danadeutsch/BedOccupancyAlarmClock/FinalProjectReports/Proposal/423Proposal.pdf

## MECH 423 Final Project Proposal The No Excuses Waking Up System

Dana Deutsch - 10631166
deutschdana@gmail.com

November 1st 2020

## Contents

1 Objectives | 3
2 Rationale | 3
3 Functions | 4
4 Bed Occupancy Detection Circuitry and Calibration | 5
5 Main MCU Timing Code for Alarms | 11
6 Phone audio detection and audio output | 12
7 Most Critical Module | 13
8 Risk and Countermeasures | 15
9 Learning Objectives | 15

## 1 Objectives

The goal of this project is to create an alarm clock system for people who have a hard time waking up and getting out of bed. Many people simply turn off their alarms and fall back asleep. Then they must to set multiple alarms at various intervals to remind themselves to get up. This is a temporary solution since you can still turn off all the alarm and stay in bed. My objective of my system is to eliminate the possibility of remaining in bed by taking away the power to fully ”turn off” the alarm while keeping a short ”snooze” functionality. The reason for the snooze is because people enjoy laying in bed for a few minutes before fully waking up and a consistent alarm while in bed will get annoying. Since most people don’t use a physical alarm clock and instead use their phones, this system will work best if it were to interface with the phone people already use.

Creating a phone application interface is outside the scope of this project as it adds a lot much functions and complexity for the short timeline provided. Instead the goal of the project is to use the phone alarm sound as a trigger point for an bed detecting alarm system which operates separate from the phone, This way the main alarm can be set on the phone which users already have set up since it has a better interface and more alarm features. However , the device run on the a microcontroller still operates in respect to the phone. The device will sense when the phone alarm goes off in order to begin its functions instead of having its own internal real time clock and alarm setting capacity. After the original alarm, the device will periodically ring after the user ”snoozes” until the user leaves the bed and doesn’t return to bed for a set amount of time. The device will look like a small box that is placed by the bed right where the user normally places their phone to charge. The device will have small wires leading to sensors under the bed to connect to the detection circuitry.

## 2 Rationale

I want to make this device since it solves a problem I face daily along with many other people. Instead of setting up 5 different alarms which are close together and spread out to make sure I get up, I can use this device. I sometimes ignore my alarms and just decide to keep sleeping so this way I will be forced to get up and hopefully fix my sleeping scheduled. This product isn’t available on the market right so its only achievable by making it myself. I hope this project will provide a concept functionality prototype for a possible market device that uses this method or a better phone app interface. As well many home automation can be made using the bed occupancy detection function like starting the coffee maker when you leave the bed. An example of how I imagine a final product to look like is found in Figure 1.


Figure 1: Concept Drawing For a Alternative Version of the Device Integrated in a Phone Charging Station

## 3 Functions

The functional requirements are found in Table 1. The hardware components include the microcontroller (MCU), a input force sensor for the bed, input audio sensor circuitry for detecting the phone alarm, and output buzzer to create its own alarm sounds. The MCU is used to to control the logic for when the alarm are rung and when to detect and control the inputs and outputs. The MCU code must read the output of the force and sound sensor to detect if the user is in bed or if the phone has rung based on calibration values. The MCU also sends an output signal to play a buzzer for the alarm sounds.

I created a few requirements for the functions ordered by importance. The MCU alarm ringing code cannot be tricked to stop its detection logic. The bed sensor must be able to consistently detect the user regardless of their position in bed. The detection of the user must also be integrated without compromis-ing the bed comfort or permanently changing the bed structure. The buzzer must be laud enough to wake a person from a light sleep. Since deep sleep wont be achievable in the ”snooze time”, the phone alarm will be the main sound that will wake the user. Lastly the sound detection shouldn’t get accidentally triggered by a person talking while on the bed.

Table 1: Functional Requirements for The Wake Up System
| Functions | % Effort
1 2 3 | Bed Occupancy Detection (Circuitry and Calibration Code) MCU Alarm Control Code Phone Audio Detection and Output (Circuit and Code) | 50 30 20

## 4 Bed Occupancy Detection Circuitry and Calibration

Approach and Design

For the bed detection circuitry I research possible solution and found two solutions for sensors that should work by looking at online projects. The first used half-bridge load cells, particularly the types found in bathroom scales. The second method uses thin film force sensitive resistors (FSR) which are created based on a material which changes it’s resistance due to being pinched and flexed. I had also considered off the shelf products which are expensive. The only market product I found which almost meets this function is a bed detection mat for the elderly which are used to see if the user has fell, and alert a special service to come help them. I plan to first try the half bridge strain gauges load cell solution and if it doesn’t work I have the FSR solution as backup. The reason for choosing the load cells instead of the FSR are found in this section and Table 2 summarizes this comparison. Apart from the circuitry the solution will also need to be calibrated to determine values for when the code considers the bed occupied or not.

A bathroom scale has four force sensors at the corners which are actually strain gauged sheet metal parts. Each sensor is a half bridge with each side having opposites effects from compression and tension. I plan to purchase a set from amazon from 13$ which also comes with a 24 bit Analog to Digital Converter (ADC) and amplifier , HX711, pictured in figure 2. To measures the weight we position the strain gauges in a Wheatstone bridge circuit. The HX711 then amplifies the signal across the bridge and converts it to a 24 bit digital signal to provide precision. These sensors are commonly used to create scales using an Arduio therefore there is a lot of online documentation and libraries I can read and adapt on configuring them to the MSP430. In figure 3 I show how a Wheatstone bridge interfaces with the ADC module. In figures 4 and 5, I have the block diagram for the HX711 module and Schematic for the board. The interface for the HX711 is a digital output so to read one 24 bit value I will need to input 25 clock signals and capture the outputs with an MCU code, the process is described in the HX711 data sheet and a small capture is seen in figure 6.

Since I don’t need to measure the exact weight of the user for this function, only a change is the overall detected weight, I plan to place the sensors at only one or two corners of the bed which should create sufficient detection without capturing the full forces of the bed. This makes the device easier to use, install, and over all more adjustable for other beds. Another positive aspect of the design is that it doesn’t inter-fere with the mattress or pillow which can make changing the sheets more difficult or reduce user comfort.


Figure 2: The 4 bathroom scale load cells and 24 ADC module

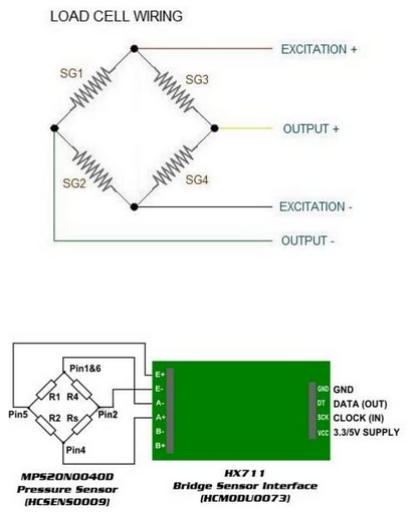
[picture p37: figure]

Figure 3: Measuring Across a Wheatstone Bridge

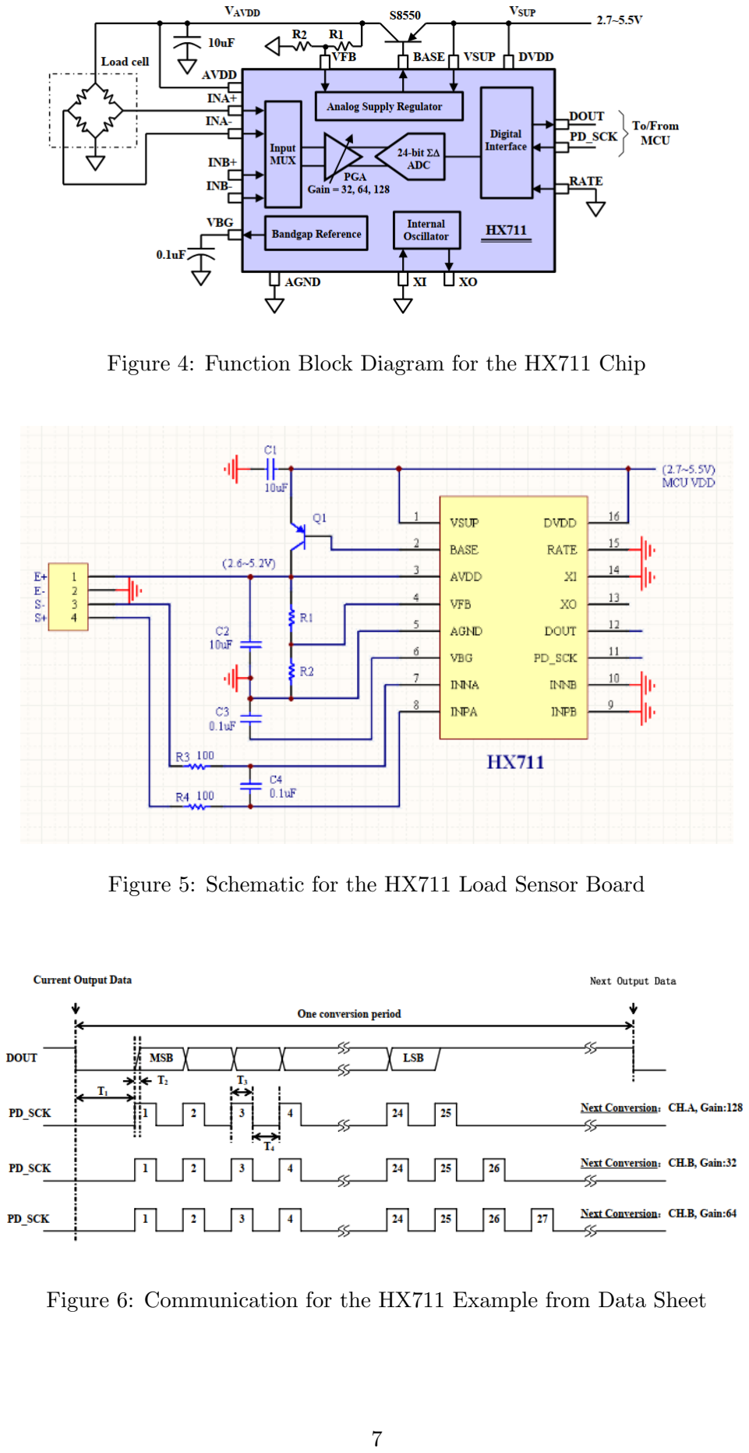
[picture p38: page 7]

Figure 4: Function Block Diagram for the HX711 Chip

Figure 5: Schematic for the HX711 Load Sensor Board

Figure 6: Communication for the HX711 Example from Data Sheet

From concept testing I devised that placing two sensors under the corner of the bed should be sufficient since each sensor supports up to 50kg. The rough measurements I got from my preliminary test was around 32kg appearing at one corner with myself laying on the bed. I want to include a margin for larger beds as mine is light, other weight users, and safety. Figure 7 shows my test of an opened bathroom scale with the two gauges removed and placed under one bed leg. In this picture I show an empty bed at 15kg under a bed leg. The full diagram of the circuit I plan to make is found in figure8.

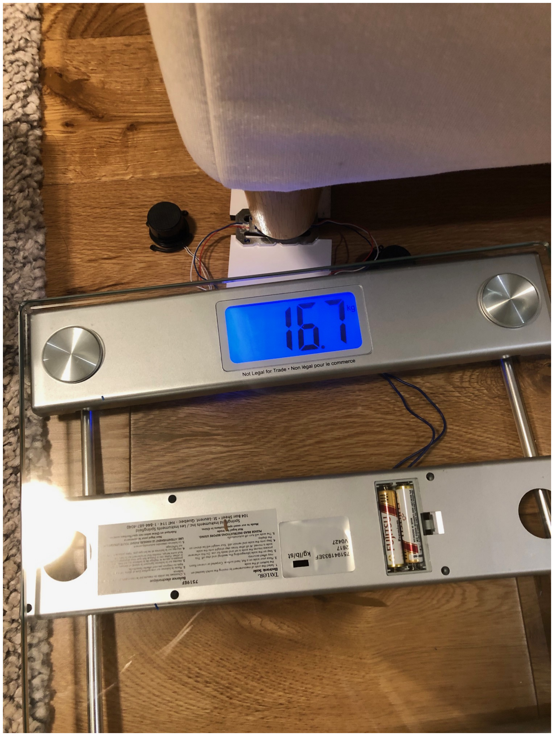
[picture p39: figure]

Figure 7: Preliminary Test With Bathroom Scale


Figure 8: Connection Schematic for The Full Load Cell design

The second solution I am considering as a back up is using force sensitive resistors (FSR). This thin film resistor reduce their resistance when pinched or flexed. I plan to use a long thin resistor which will also detect flex and place it under the mattress on top of the bed slats. Other possible locations to mount this resistors also include right under the user head on the pillow, and right under the user upper body on top of the mattress. The measured value from this is an analog input into the MCU’s ADC. However, this solution might cause interference with the bed sheets and might not have enough pressure to provide results. Also to recognize if the user is on the bed in any position I may need more than one resistor and spread them out on the bed. As well different bed frames and mattresses flex a different amount so there is uncertainly if my bed would work. I have also read that these resistors are fragile and I want the product to be robust and durable with different beds. For these reasons and those in 2, this will be my backup solution. Figure 9 and figure 10 show the FSR and how it can be connect to the MCU in a voltage divider.


Figure 9: Preliminary test with bathroom scale

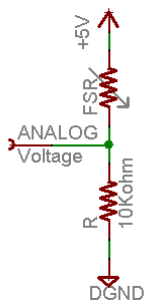
[picture p40: figure]

Figure 10: Preliminary test with bathroom scale

Table 2: Comparing the two top bed detecting occupancy solutions
Solution | Positives | Negatives
Load Cells | Independent to actual bed structure Worked in online sources Cheaper | Each cell max to 50kg More complex electrical setup and integration Need mechanical holders for the gauges
FSR | Simple circuit and code No mechanical setup | At least double the cost Require positioning around the mattress Could snag wiring from sheets

Inputs and Outputs

The main input to this function is the person providing force by laying on the bed. As well, we provide the supply voltage VCC from the MCU for the sensor circuit. The main output is the digital or analog value of the detected voltage. Each concept has different inputs and outputs seen in the table 3. The table lists both the output of the circuit and the output from the reading sensor code needed to read the circuit voltage output.

Table 3: Output for Bed Detection Concepts
Concept | Inputs | Outputs
Load Cells | Pulses for reading ADC value VCC | Circuit: Digital value for the voltage from ADC Code: A state variable post calibration value comparison
FSR | VCC | Circuit: Analog voltage for MCU’s ADC10 Code: A state variable post calibration value comparison

Parameters

I will need to power the sensors at Vcc and detect the output value. The main parameter is the voltage value which is measured across the changing resistances. As well I need need a parameter for calibration of an empty bed and another value as the passing value to signify a person is in bed.

Development Plan

I have two development plans, one for each concept.

Half-Bridge force sensor:

Connect full bridge detection circuitry using only two force sensors

Create MCU code to read the digital outputs

Determine if the change is significant when off and on the bed

Connect 4 force sensors in the bridge at two different corners if needed

Determine calibration values

FSR resistor force sensor:

Connect detection circuitry

Create MCU code to read the ADC values

Determine if the change is significant when off and on the bed by moving around the placement of the resistors to various positions around the bed

Determine calibration values

Test Plan

To test the user detection I will lay at various locations on the bed and read the outputs. If the location and position is indeterminate to the final output from the reading code and all pass as the user is in bed than I will consider it a pass. An optional test which isn’t critical is to place various items like a laptop, laundry basket, and some textbooks on the bed to check the detection isn’t too sensitive. This test doesn’t need to pass since alarm wont be sounding in these cases.

## 5 Main MCU Timing Code for Alarms

Approach and Design

The MCU is the control behind when the alarms go off based on our hardware inputs. The flowchart to the logic behind the alarms are found in figure 5. The code will relay on the use of MCU timers. I will be creating this code under assumptions that the inputs will be digital high or low values simulated using IO pins. This will be changed when combining this function’s MCU code with the code for reading each sensor. Some features of the flowchart include not ringing the alarm originally if the person isn’t in bed but still check they don’t return to bed in case they just happen to get up a few minutes before the alarm. As well if the person returns to bed after exiting, the counter for waiting at least an hour to ensure they don’t return will be reset.

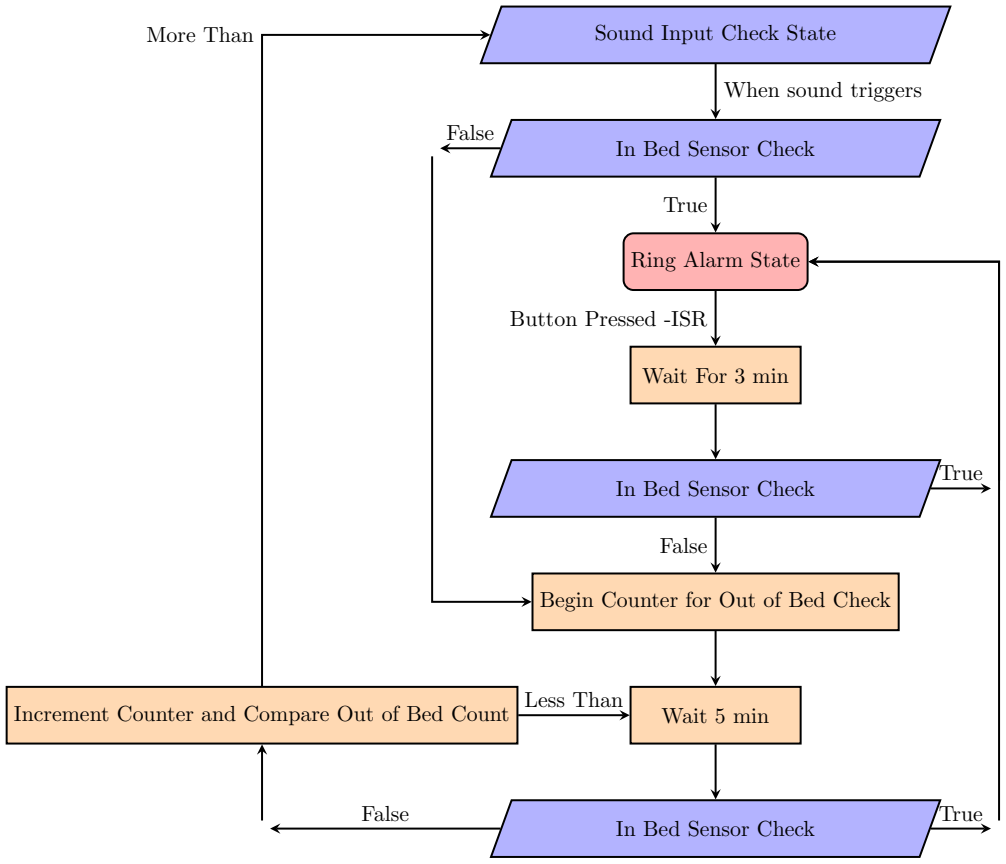
[picture p41: figure]
Sound Input Check State; In Bed Sensor Check; Ring Alarm State; Wait For 3 min; Begin Counter for Out of Bed Check; Wait 5 min; When sound triggers; True; False; Button Pressed -ISR; Less Than; More Than

Increment Counter and Compare Out of Bed Count

Figure 11: Flowchart for the Alarm Actuation Logic

Inputs and Outputs

The main input is the determined output from the bed occupancy detection. This will be a Boolean value to determine if the level passed the allowed amount and the person is in bed. The second input is the output from the phone audio sensor which actuates the entire flow chart. The third input is a snooze button for the user to temporarily turn off the alarm. Finally we have the output buzzer to get the user out of bed which will be set with a PWM signal to change frequencies of sound. I would also want to include some LEDs for user visual feedback to show if the device is sensing a person in bed and that the device is either idle or in the wake up sequence.

Parameters

The software will check and use the following to function:

The state of the bed as a digital high or low

The state of the audio volume as a digital high or low

Count of number of times the secondary alarm has gone off to provide enough time for out of bed detection

Time for waiting between snooze to be converted into frequency of the timer and possibly a count variable is frequency isn’t achievable

Time for waiting between checking if the bed is still empty to be converted into frequency of the timer and possibly a count variable is frequency isn’t achievable

PWM duty cycle for the piezo buzzer

Development Plan

I will develop this function first independently from the other functions and than merge them. Therefore originally the inputs to the system will be simulated before the real inputs are merged.

Develop code for the first half of the flow chart which stops the snoozing loop when user exits bed

Use a buzzer output, snooze push button input, and digital high or low values for the bed and volume detection to test the state machine

Develop the second half of the flow diagram code that checks the our of bed sequence

Test flow again

Swap the digital inputs for the outputs of the other functions when merging

Test Plan

Testing on the code will be preformed using test cases based testing of the state machine. I will basically pretend to be the user using the simulated inputs. I will try combinations of ”leaving” and ”exiting” to test the state machine.

## 6 Phone audio detection and audio output

Approach and Design

This function encompasses the two sound related traducers I plan to use and the code controlling them. To detect the phone alarm, as long as the phone is placed right on top of the product, I can measure the volume of sounds and only actuate on laud enough sounds using a microphone. I found a microphone attached with a audio amplifier board seen in figure 12. The schematic of this board is found in figure 13 which uses the MX4466 Op-Amp. Reading the analog input with the ADC on the MCU I can determine the value for the phone ringing to calibrate the sensor. Other sensors are also available with can be adjusted with an external resistor to provide a digital output once the voltage is overcome. This type can be used to create an IO pin interrupt instead of using the ADC.

Figure 12: The Audio board in Plan

To create the output alarm I plan to use a piezo buzzer which I already have from another project. This is of lesser importance since the sound quality and volume wont be deterministic of the functionality and can be adjusted at a later date. To provide voltage to the buzzer I will provide a PWM signal to control the output.

Inputs and Outputs

The input to the buzzer system is a Boolean value from he main code to trigger the buzzer. As well the input to the microphone is the sound of the phone alarm to the microphone creating the signal for detection. The system output is a PWM signal to power the buzzer to output sounds. The microphone sensor output is a signal that needs to be read by the MCU’s ADC.

Parameters

The main parameter is the value for calibrating if the audio sensor has heard the phone ringing alarm. The second parameter is then the Boolean value to provide to the main MCU code as input. The third value is the duty cycle which controls the buzzer.

Development Plan

The plan is to develop the buzzer first as its simpler while I am focused on bed detection and main code functions. Only later will I test the microphone since it is a lower deterministic function and the device will still mainly function without it. This is mentioned in section 8 where I discuss the risks.

The plan:

Connect buzzer and check it’s sound and adjust pwm input

Connect microphone and create MCU code to read its values

Determine if microphone can distinguish the alarm should from normal background noise

Record calibration value

Test Plan

The test plan for the buzzer is simple, see if the sound is outputted and is heard well enough. For the microphone I want to test various phone alarm tones to check it can detect them and detain how close or far away to the microphone I need to be in order to trigger my code.

## 7 Most Critical Module

The most critical and deterministic function is the bed occupancy detection since without it the whole thing wont work. For this reason I have outlined two solutions for the detection system. I have already


Figure 13: Microphone Board Schematic preformed preliminary tests on the half bridge concept by disassembling a bathroom scale and placing on of its sensors under a leg of my bed, seen in figure 7. The scale displayed two different values when the bed was empty and occupied. This proves that this method would function once it is properly imple-mented though implementation could be tricky. There is no preliminary test I can do for the FSR before purchasing it and testing it as outlines in its development plan.

## 8 Risk and Countermeasures

The biggest risk is not getting the bed detection to work which is the most critical function. Because of its complexity it could be time heavy as well and therefore I will prioritize this function over the rest which could cause the other functions to be incomplete. I have two methods for this function as a countermeasure if one doesn’t work. If I am not able to get the bed detection to work on the bed I will try to show a proof of concept solution. This could be making it into a chair occupancy instead which is a more rigid structure and has a smaller scale than the bed.

Another risk is the sound sensor not being sensitive enough and wont distinguish between an alarm or someone yelling in the room. Finally a big risk is not being able to implement all functions in time. I am open to the possibility if I ran out of time to not complete the audio sensor as it’s a simpler function and the device still work with a button to begin its functionality instead. All it will mean for the user, is that they turn the device on instead of it being related to the phone. I will try to start my main two functions early for this risk. As well due to the at home situation, if something need to be purchased it could take longer to arrive or I will be delayed if I need to get emplacements for sensors. There is no avoiding this risk except purchasing the sensors early to make sure i have time to exchange if they wont work and have enough time for shipping.

## 9 Learning Objectives

By preforming this project I will work on my MCU coding skills by creating a flow of code functions. I will use timer functionality, and ADC functionality as well as general ISR and IOs. I will learn about audio signals from the volume sensor and buzzer. Finally I will gain experience using Wheatstone bridge for strain gauges sensors and learning about their uses.
