danadeutsch/BedOccupancyAlarmClock/FinalProjectReports/presentation/fullcycle.xlsx

Time | Xo [counts] | Vo [counts/s]
8679944
8680052
8679913
8679929
8679883
8680201
8679842
8679853
8679941
8679930
8679928
8679889
8679875
8679910
8679892
8679938
8679905
8679935
8679960
8679914
8680008
8679899
8679946
8679954
8679932
8679915
8679947
8679907
8679899
8679967
8679852
8679918
8679916
8679932
8679937
8679950
8680133
8680003
8680370
8680310
8679803
10069253
9878541
9840378
10004138
9982004
9974542
9981735
9959610
9796029
9803634
9797335
9896620
10094777
9948625
9878324
9847597
9851958
9849582
9859729
9832212
9500629
9623865
9489222
9506327
9522563
9526311
9525368
9548246
9579059
9573851
9584079
9566930
9555485
9536613
9536062
9536033
9537856
9538532
9538221
9539776
9546887
9600159
9740700
9740700
9690989
9684781
9693465
9667196
9650987
9639574
9646911
9396952
9444494
9745314
9688479
9672544
9689875
9685917
9688467
9686674
9817786
9813047
9823850
9691509
9736422
9729311
9725384
9720872
9721176
9722284
9724227
9721374
9717868
9721493
9721548
9722482
9722953
9720951
9823713
9819952
9821782
9623075
9712462
9724785
9725510
9723284
9723837
9729213
9726556
9729632
9727652
9696369
9766243
9762671
9753477
9845710
9828516
9889332
9552332
10118113
8681930
8681029
8681501
8681210
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
