danadeutsch/BedOccupancyAlarmClock/FinalProjectReports/Final/UI.PNG

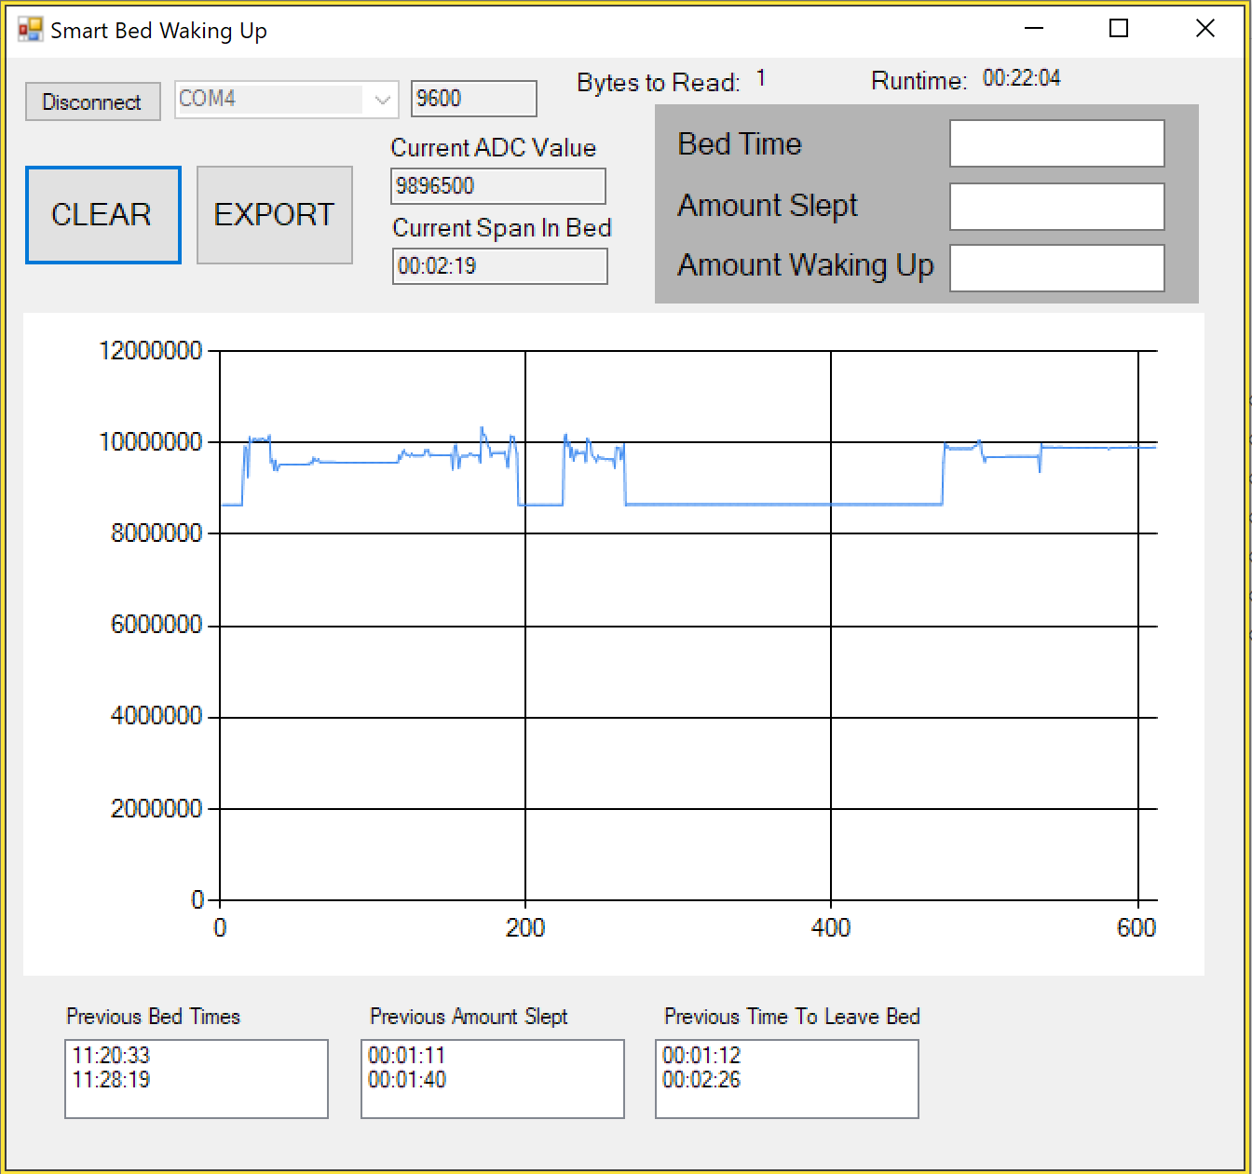
FinalProjectReports/Final/UI.PNG
