danadeutsch/BedOccupancyAlarmClock/FinalProjectReports/Final/underBedLed.PNG

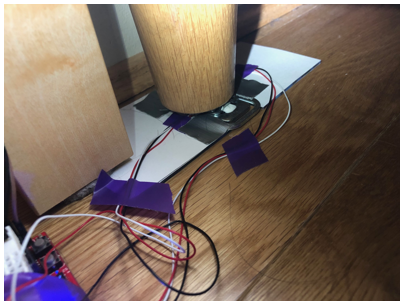
FinalProjectReports/Final/underBedLed.PNG
