danadeutsch/BedOccupancyAlarmClock/FinalProjectReports/Final/underBedLegUnloaded.PNG

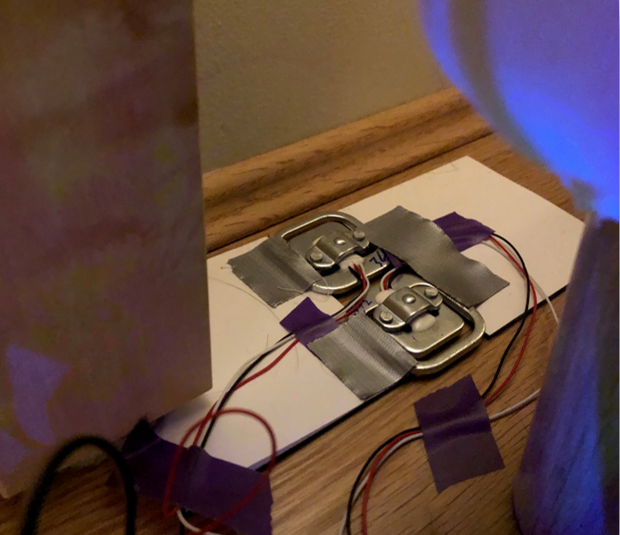
FinalProjectReports/Final/underBedLegUnloaded.PNG
