danadeutsch/BedOccupancyAlarmClock/FinalProjectReports/presentation/display.PNG

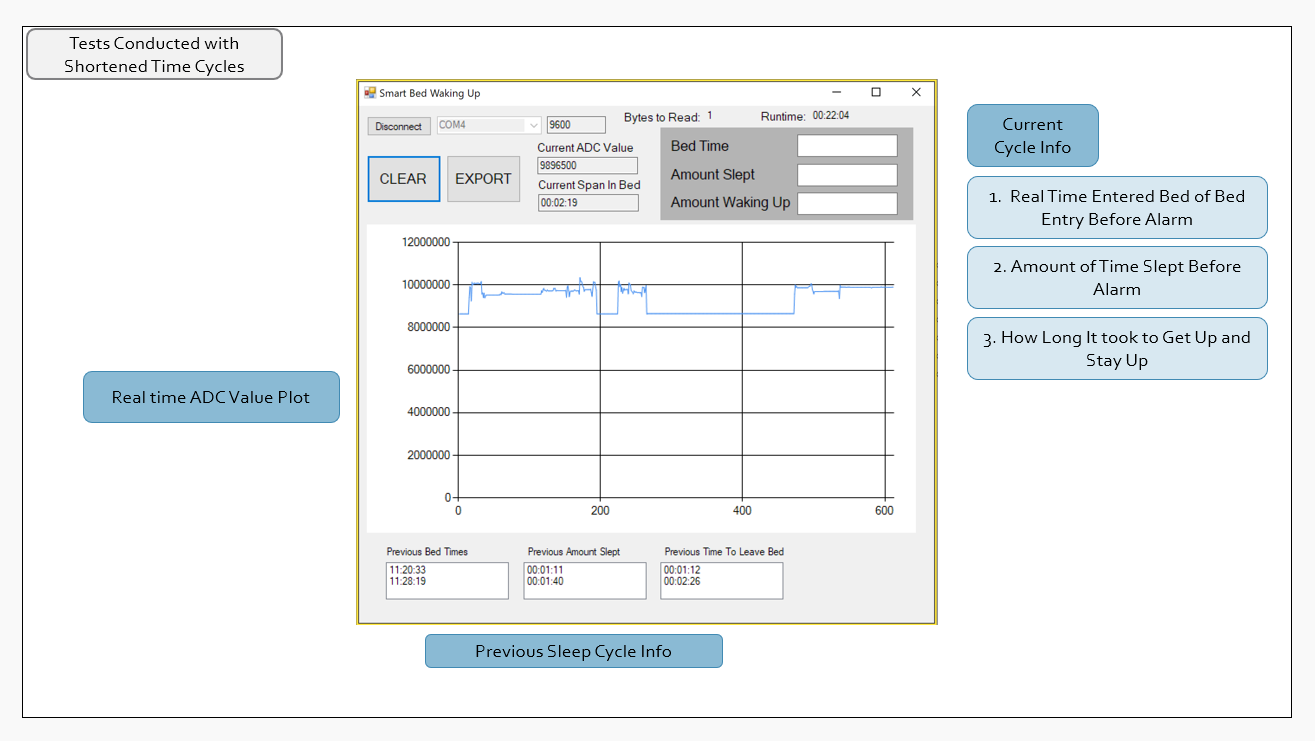
FinalProjectReports/presentation/display.PNG
