danadeutsch/BedOccupancyAlarmClock/FinalProjectReports/presentation/fullCycleDataLables.png

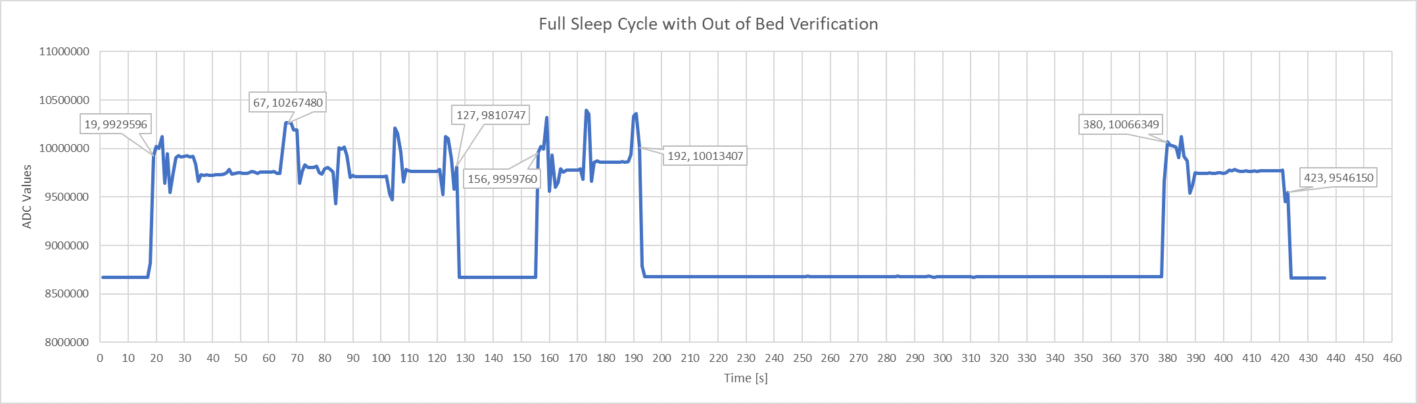
FinalProjectReports/presentation/fullCycleDataLables.png
