danadeutsch/BedOccupancyAlarmClock/FinalProjectReports/presentation/phone.JPG

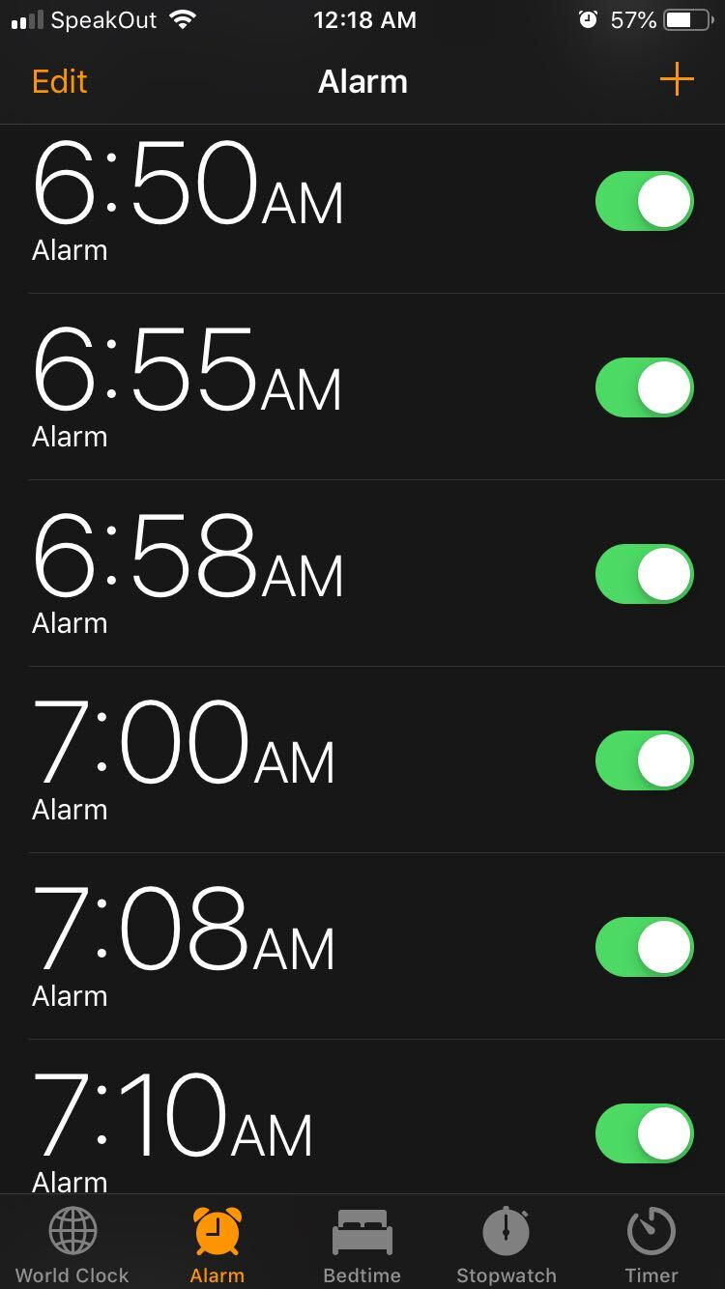
FinalProjectReports/presentation/phone.JPG
