danadeutsch/BedOccupancyAlarmClock/FinalProjectReports/presentation/Smart Bed Waking Up 11_27_20 9_32_09 PM.png

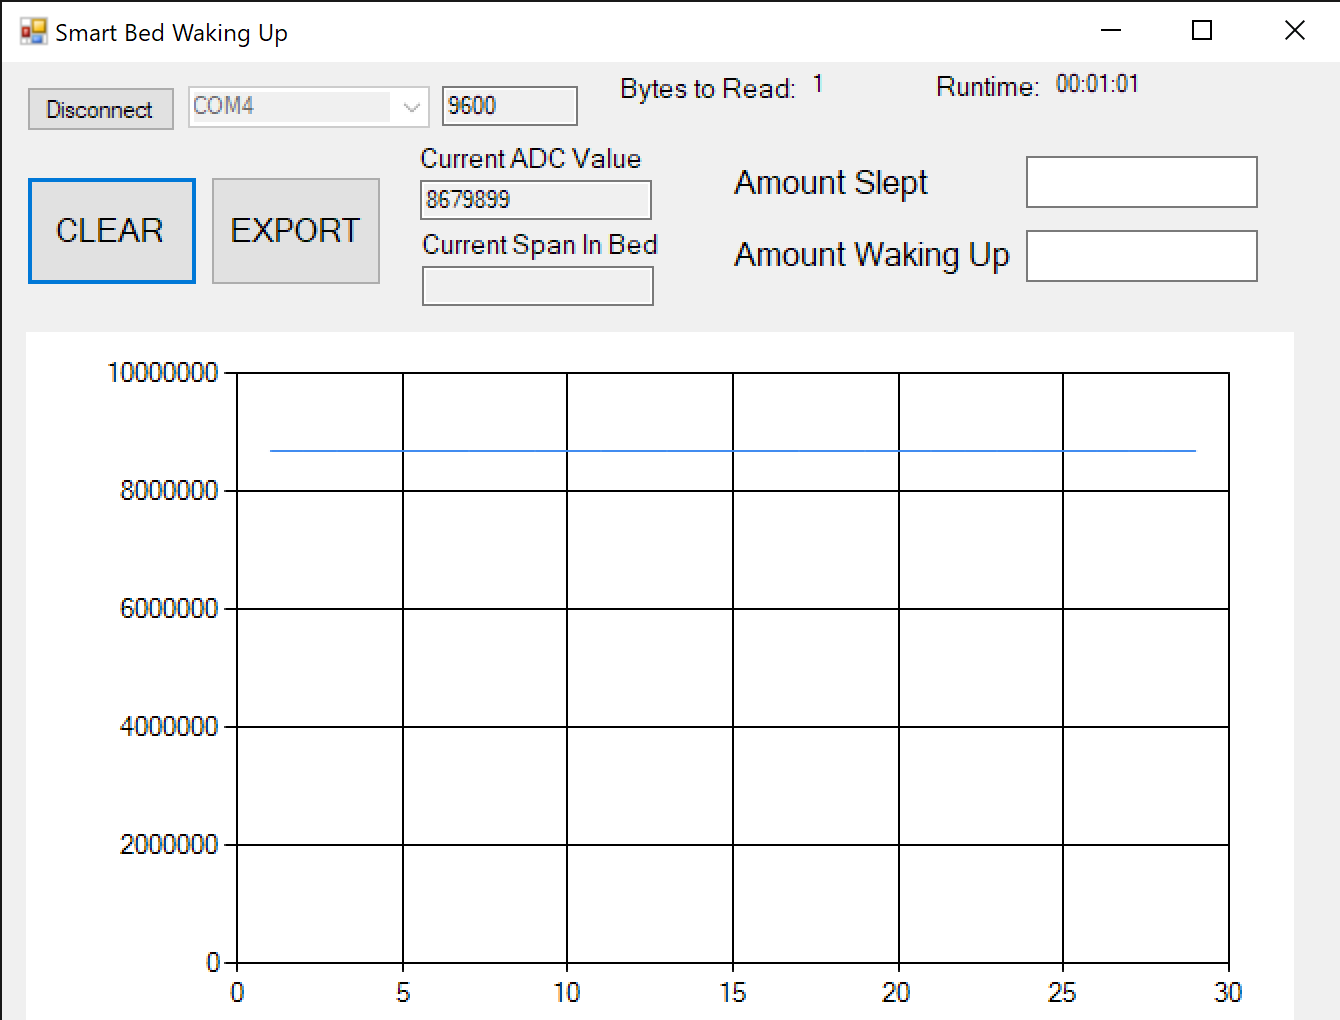
FinalProjectReports/presentation/Smart Bed Waking Up 11_27_20 9_32_09 PM.png
