danadeutsch/BedOccupancyAlarmClock/FinalProjectReports/presentation/Smart Bed Waking Up 11_27_20 9_34_10 PM.png

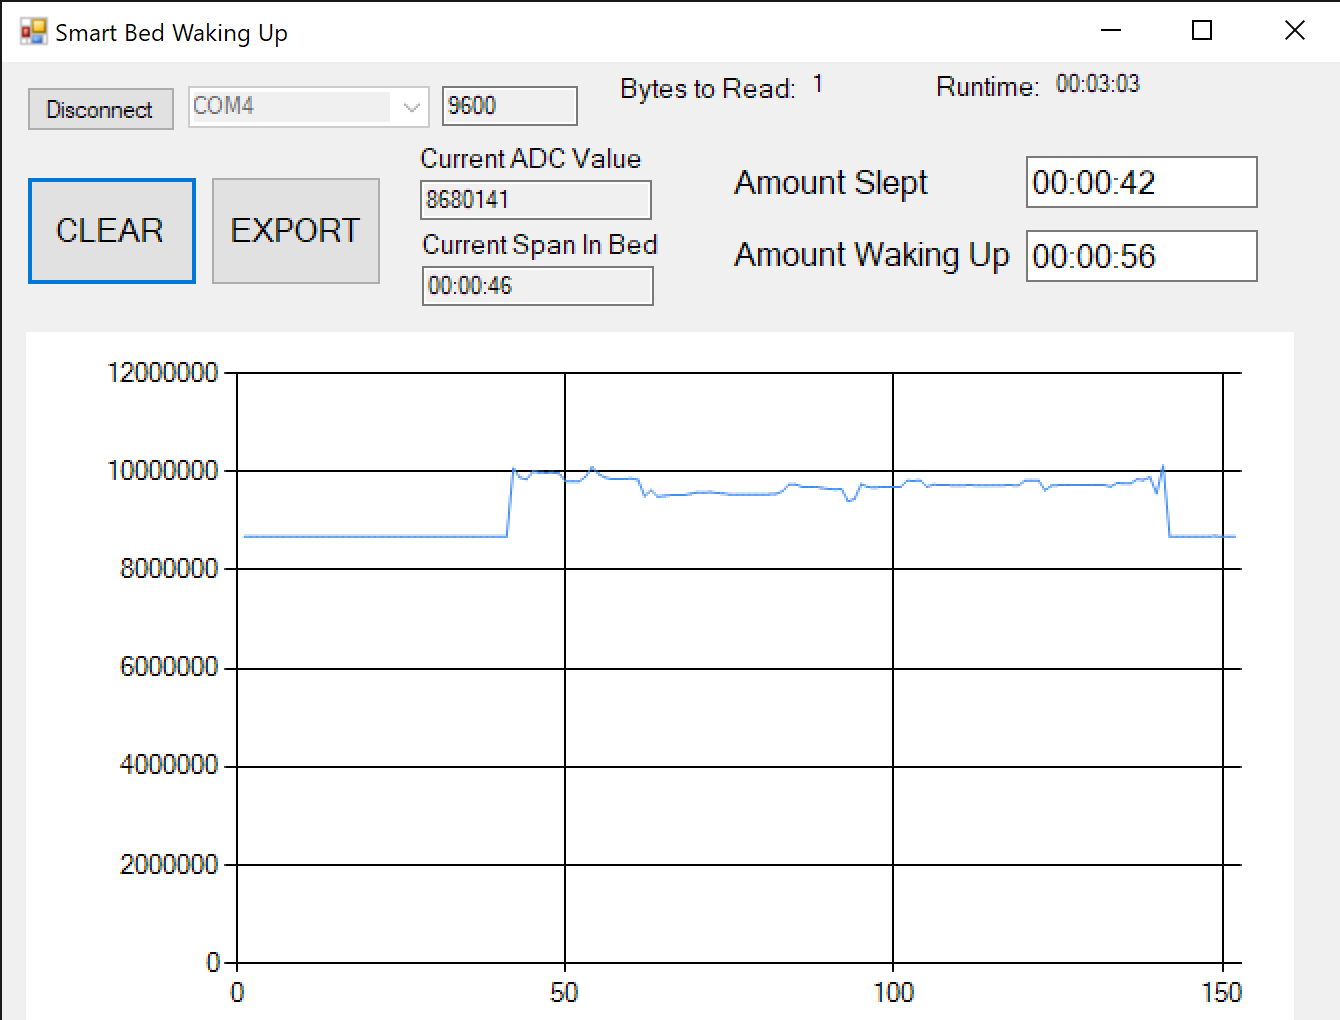
FinalProjectReports/presentation/Smart Bed Waking Up 11_27_20 9_34_10 PM.png
