danadeutsch/BedOccupancyAlarmClock/FinalProjectReports/presentation/Smart Bed Waking Up 11_27_20 9_35_15 PM.png

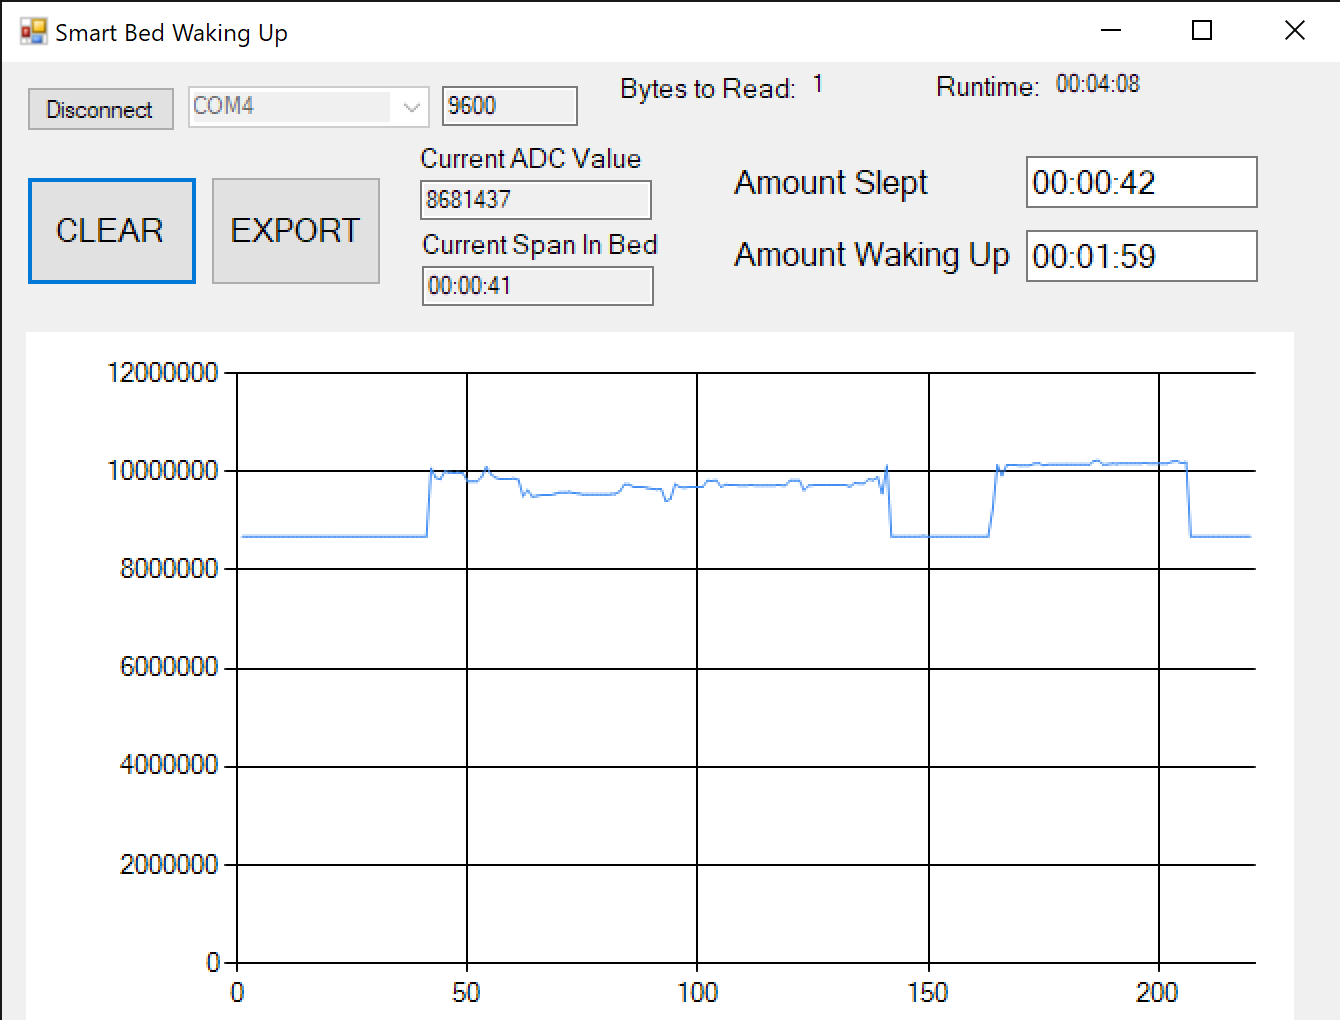
FinalProjectReports/presentation/Smart Bed Waking Up 11_27_20 9_35_15 PM.png
