danadeutsch/BedOccupancyAlarmClock/FinalProjectReports/presentation/Smart Bed Waking Up 11_27_20 10_05_53 PM.png

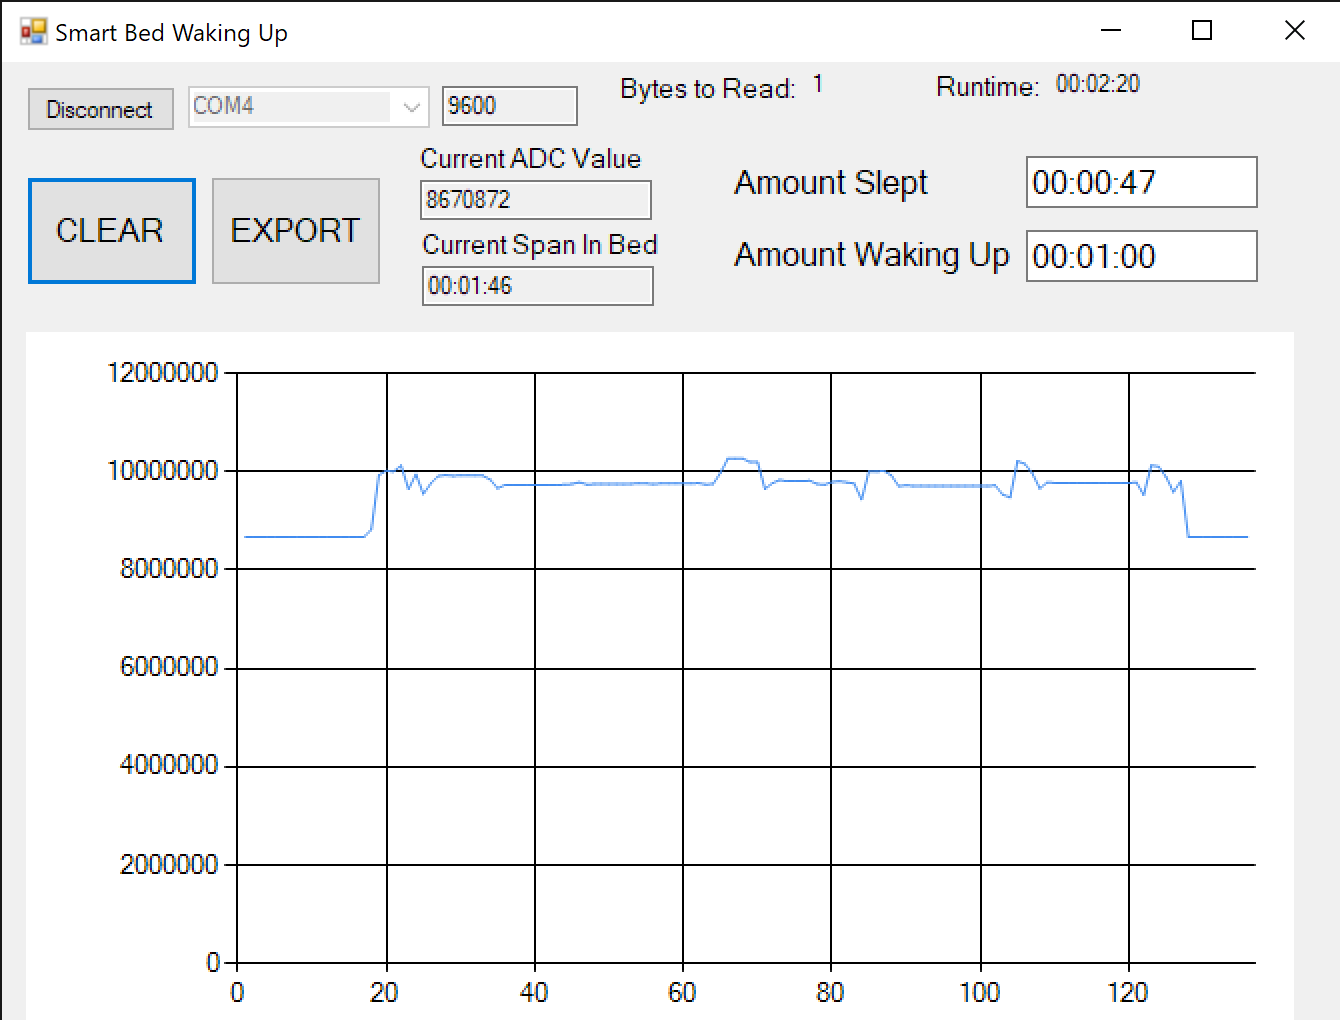
FinalProjectReports/presentation/Smart Bed Waking Up 11_27_20 10_05_53 PM.png
