danadeutsch/BedOccupancyAlarmClock/FinalProjectReports/presentation/Smart Bed Waking Up 11_27_20 10_10_42 PM.png

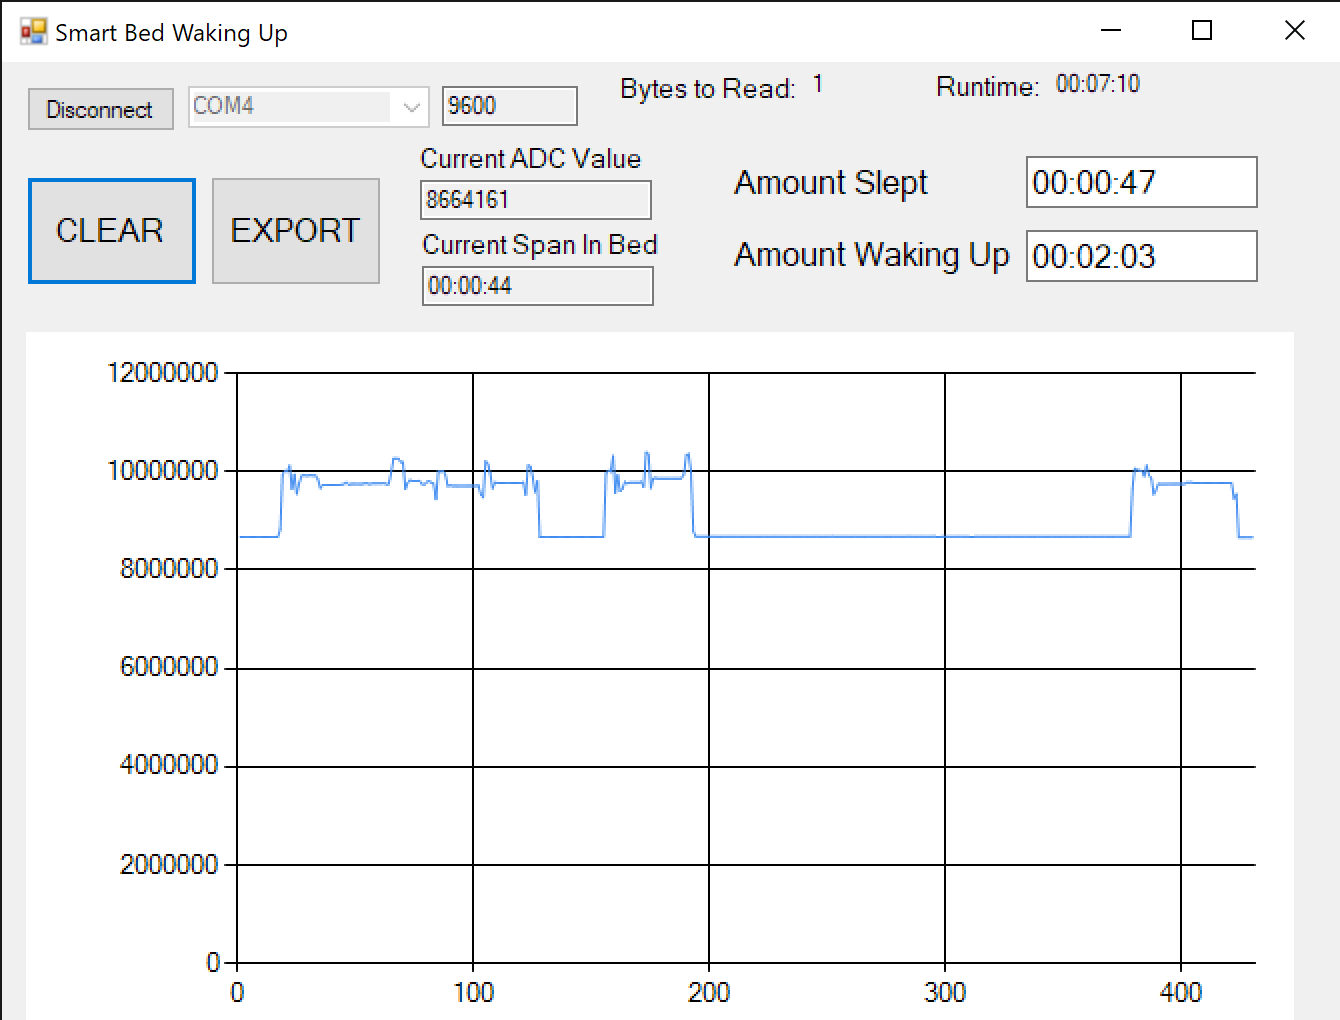
FinalProjectReports/presentation/Smart Bed Waking Up 11_27_20 10_10_42 PM.png
