danadeutsch/BedOccupancyAlarmClock/FinalProjectReports/presentation/systemdiagram.PNG

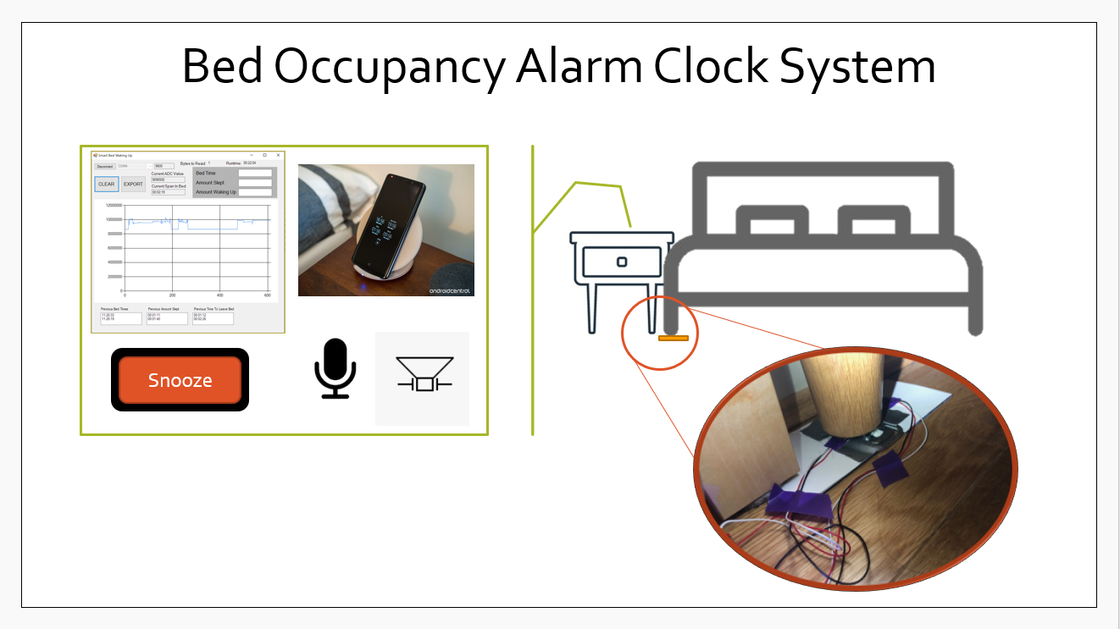
FinalProjectReports/presentation/systemdiagram.PNG
