danadeutsch/BedOccupancyAlarmClock/FinalProjectReports/presentation/thanks.PNG

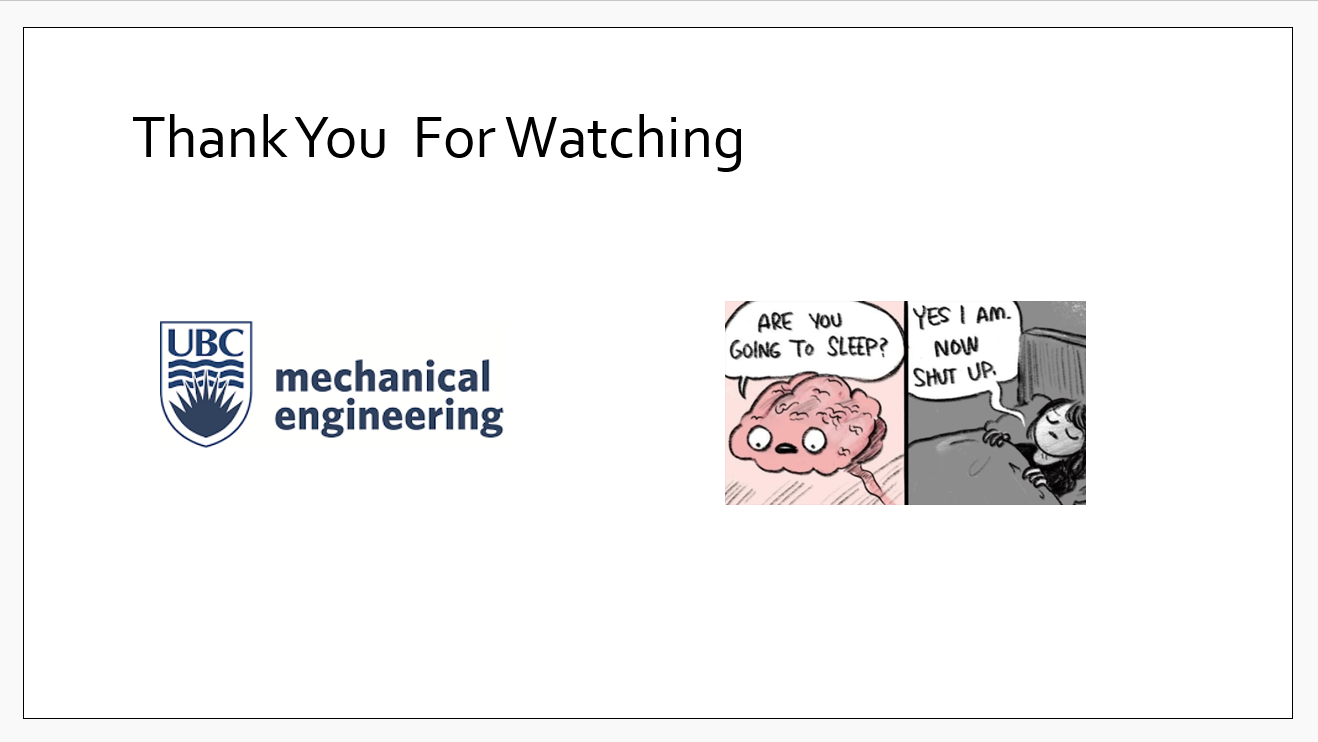
FinalProjectReports/presentation/thanks.PNG
