danadeutsch/BedOccupancyAlarmClock/FinalProjectReports/presentation/title.PNG

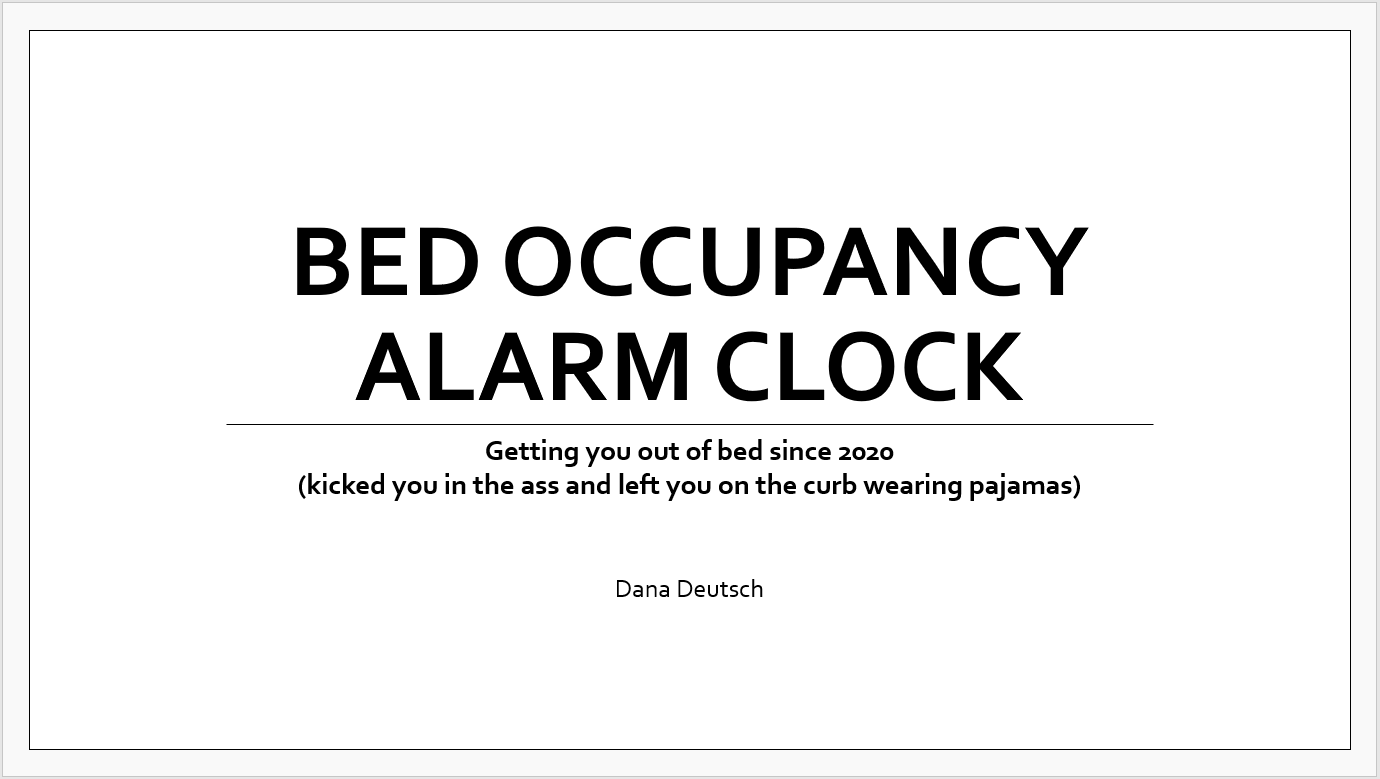
FinalProjectReports/presentation/title.PNG
