danadeutsch/BedOccupancyAlarmClock/FinalProjectReports/Proposal/4halfbridge connections.PNG

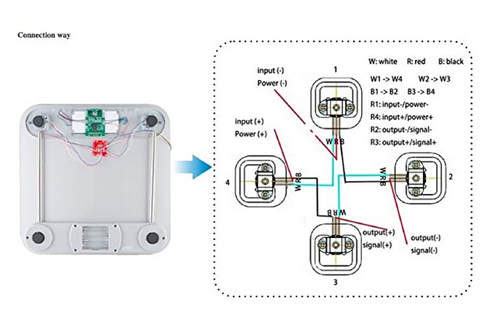
FinalProjectReports/Proposal/4halfbridge connections.PNG
