danadeutsch/BedOccupancyAlarmClock/FinalProjectReports/Proposal/hx177Code.PNG

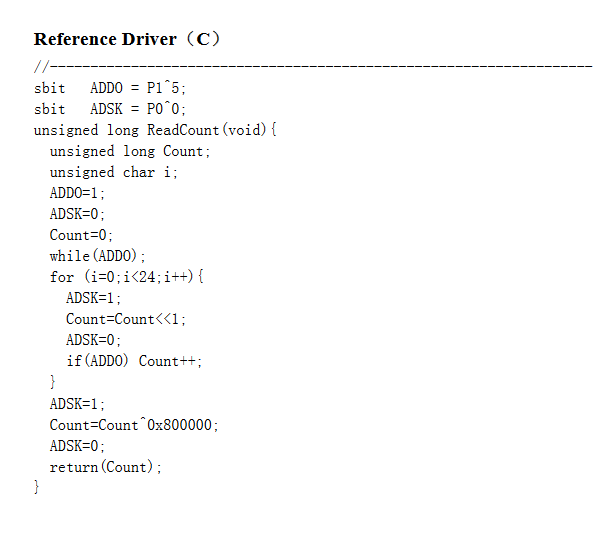
FinalProjectReports/Proposal/hx177Code.PNG
