danadeutsch/BedOccupancyAlarmClock/FinalProjectReports/Proposal/patientAlarmproduct.PNG

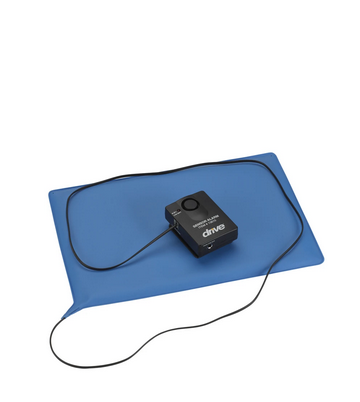
FinalProjectReports/Proposal/patientAlarmproduct.PNG
