danadeutsch/BedOccupancyAlarmClock/FinalProjectReports/Proposal/piezoBufferdivider.PNG

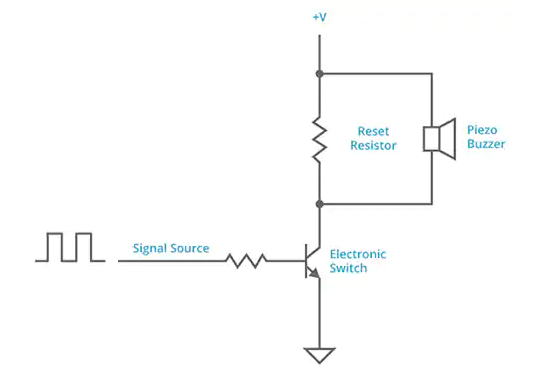
FinalProjectReports/Proposal/piezoBufferdivider.PNG
