danadeutsch/BedOccupancyAlarmClock/FinalProjectReports/Proposal/rpmMotor10to40.PNG

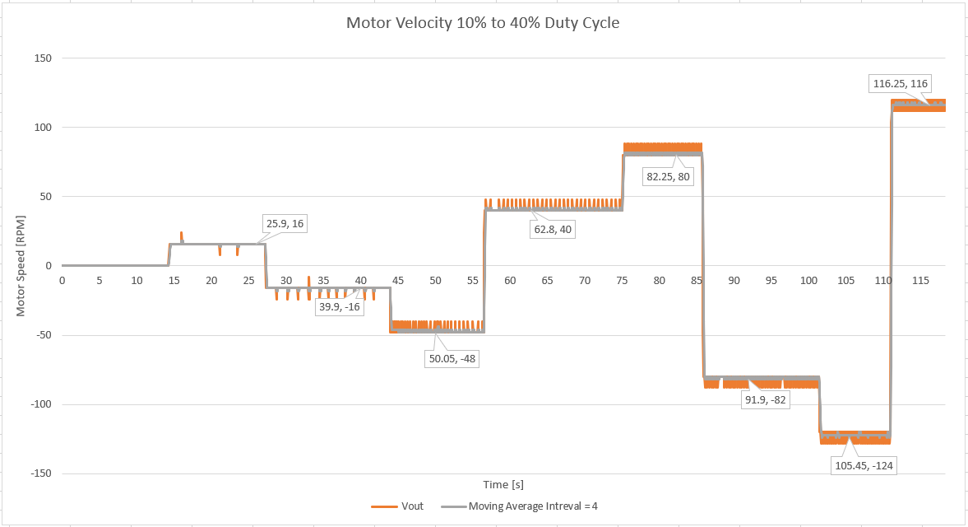
FinalProjectReports/Proposal/rpmMotor10to40.PNG
