danadeutsch/BedOccupancyAlarmClock/(commit log)

2020-11-11 added proposal and other refrence documents
    [BedOccupancyProduct.kicad_pcb, BedOccupancyProduct.sch]
2020-11-16 code for initial timer and snooze control
    [BedOccupancyProduct.sch]
2020-11-22 timers working with constant buzzer
    [BedOccupancyProduct.sch]
2020-11-22 combining the two testing codes, form for reading ADC stream created
2020-11-23 foce value recording files
    [bedmass.CSV, bedmass2.CSV, rollingInBed.CSV, sitting at bed edge.CSV, sleep plus sitting.CSV, standingOppositCorner_sittingAtpillow.CSV]
2020-11-24 fix serial packet reader for long term connection
    [2_28_43.CSV, didnt work.CSV, long.CSV, long2.CSV, nap and off.CSV, nap2.CSV]
2020-11-25 added command byte to serial
    [bedmass.CSV]
2020-11-26 schematc update
    [BedOccupancyProduct.sch]
2020-11-28 full cycle works recorded
    [fullcycle.CSV]
2020-11-28 schematic made smaller
    [BedOccupancyProduct.sch]
2020-11-28 second cycle recorded
    [fullcycle2.CSV]
2020-12-02 first try video
    [vidcycle.CSV]
2020-12-03 Final video
    [fullCycle.CSV]
2020-12-03 final Report images
    [fullcycle.xlsx, fullcycle2.xlsx]
